hyshum/19-13-GreenHouse/Hardware/README_HARDWARE.md

# Hardware ReadMe
The hardware portion of this project can be broken down into three core sections:
* Enternal structure
* Internal structure
* Sensor circuitry

## External Structure
The external structure of the greenhouse is has two main components: the wooden base and the PVC pipe frame. The wooden base was created by screwing together treated cedar lumber boards to create the sides of the box. These were then screwed into one piece of plywood which created the floor of the box. To make transportation of the greenhouse easier, wheels were attached to the bottom to allow the greenhouse to be rolled. The next component, the PVC pipe frame, was constructed by cutting pieces of pipe to their specified lengths and multiple differnt joints were used to connect these pieces together. A primer was then used to prepare the pipe to be cemented together. To secure the frame to the base, plastic blocks were machined to create holes large enough to securely hold the frame in. These blocks were then attached to the base using a multi-surface epoxy. After the frame was securely in place in the base, the polyethylene plastic was attached to the frame using PVC pipe clamps. Two layers of plastic were attached to the frame, an inner and an outer layer, to create an air gap which acts as an insullation layer. The door of the greenhouse was created using two-adhesive zippers placed into a backwards L shape. When both zippers are unzipped, it creates a flap in the polyethylene that can be pulled out creating a door to the interior of the greenhouse. All of the sketches and photographs pertaining to the external structure of the greenhouse are placed in the [External-Structure](External-Structure) folder.

## Internal Structure
The internal structure of EcoHome is composed of the following: a sub-floor, four plywood supports for the sub-floor, and a heating pad. The sub-floor serves as the surface on which the plants will rest. Two pieces of plywood joined together by a continuous hinge comprise this component. To give the user easy access to the area beneath the floor, handles are found on the two sides of the plywood panels parallel to the continuous hinge. Currently, the power strip &ndash; EcoHome's main electricity provider &ndash; is located along the right cedar wall of the base. For quick maintenance, the user can raise one panel 90 degrees. However, if more exposure is needed of the area below the sub-floor, the user can lift both panels (which can collapse up to 30 degrees) and remove the component entirely.

The heating pad consists of a plywood base and five equally spaced, pine furring strips with an incandescent rope light looped between them. Four evenly spaced sets of corner brackets are fastened to the outermost furring strips. Each set of brackets are separated by a 9/16in. space, allowing the plywood supports to fit snugly between them. Since the brackets are not attached to the supports, they can be removed with a pull if maintenance needs to be done to the rope light. All of the sketches and photographs pertaining to the internal structure of the greenhouse are placed in the [Internal-Structure](Internal-Structure) folder.

_Important safety instructions for the incandescent rope light can be found in the [Internal-Structure](Internal-Structure) folder_

## Sensor Circuitry
Datasheets for the electronics used are listed below:
* [DHT11 Temperature and Humidity Module](https://www.mouser.com/ds/2/758/DHT11-Technical-Data-Sheet-Translated-Version-1143054.pdf)
* [QLOUNI Soil Moisture Sensor](https://randomnerdtutorials.com/guide-for-soil-moisture-sensor-yl-69-or-hl-69-with-the-arduino/)
* [NSL19M51 Photoresistor](https://lunainc.com/wp-content/uploads/2016/06/NSL-19M51.pdf)
* [Wemo Mini Smart Plug](https://www.belkin.com/us/support-article?articleNum=226110)
* [Ardunio Genuino Uno](https://www.farnell.com/datasheets/1682209.pdf)
* [NodeMCU (ESP8266)](https://einstronic.com/wp-content/uploads/2017/06/NodeMCU-ESP8266-ESP-12E-Catalogue.pdf)
* [Incandescent Rope Light](https://persik.com/collections/rope-lights/products/persik-18-feet-red-rope-light-for-indoor-and-outdoor-use-pack-of-2-total-36-feet-length)

All of the diagrams pertaining to the electronics involved in the greenhouse are placed in the [Sensor-Circuitry](Sensor-Circuitry) folder.

### Bill of Materials:
_For items purchased online, a link is provided to connect you to corresponding webpage._

Item | Cost per Item | Quantity | Number Included in Package | Total Cost |
---- | ------------- | -------- | -------------------------- | ---------- |
PVC Pipe | $5.13 | 4 | 1 | $20.52
[PVC Joint: 90 Degree Elbow](https://www.amazon.com/gp/product/B01LVUU8EX/ref=ppx_yo_dt_b_asin_title_o04_s00?ie=UTF8&th=1) | $2.13 | 2 | 1 | $4.26
[PVC Joint: 45 Degree Elbow](https://www.homedepot.com/p/Charlotte-Pipe-1-1-2-in-PVC-Sch-40-45-Degree-S-x-S-Elbow-PVC023091400HD/203812169) | $1.26 | 4 | 1 | $5.04
PVC Primer and Cement | $9.17 | 1 | 1 | $9.17
[PVC Joint: 4-Way Tree](https://smile.amazon.com/gp/product/B072C2FBJJ/ref=ppx_od_dt_b_asin_title_o00_s00?ie=UTF8&psc=1) | $15.25 | 1 | 4 | $15.25
[Snap Clamps](https://smile.amazon.com/gp/product/B00C7DPS2S/ref=ppx_od_dt_b_asin_title_o00_s01?ie=UTF8&psc=1) | $10.45 | 4 | 10 | $41.80
Cedar Lumber: 2in. x 10in. x 12ft. | $18.77 | 1 | 1 | $18.77
BC Plywood: 4ft. x 4ft. | $20.88 | 1 | 1 | $20.88
[Polyethlene Film: 12ft. x 25ft.](https://smile.amazon.com/Greenhouse-Plastic-Polyethylene-Covering-Solution/dp/B00BM8HHKK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) | $57.94 | 1 | 1 | $57.94
Adhesive Zipper | $17.99 | 1 | 1 | $17.99
Incandescent Rope Light | $33.98 | 1 | 2 | $33.98
Continuous Hinge (30in.) | $7.47 | 1 | 1 | $7.47
Corner Brace (2in.) | $2.56 | 3 | 4 | $7.68
Corner Bracket | $7.48 | 1 | 20 | $7.48
Wood Screws: #4 x 1in. | $1.18 | 4 | 10 | $4.72
Wood Screws: #8 x 1/2in. | $9.19 | 1 | 1 | $9.19
BC Plywood: 1/2in. x 2ft. x 4ft. | $13.92 | 2 | 1 | $27.84
Pine Furring Strip: 1in. x 2in. x 8ft. | $1.42 | 1 | 1 | $1.42
Door Handle | $2.97 | 2 | 1 | $5.94
Ardunio Genuino Uno | $22.00 | 1 | 1 | $22.00
[DHT11 Temperature and Humidity Module](https://www.amazon.com/HiLetgo-Temperature-Humidity-Arduino-Raspberry/dp/B01DKC2GQ0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) | $9.99 | 2 | 5 | $9.99
NodeMCU (ESP8266) | $8.39 | 1 | 1 | $8.39
[QLOUNI Soil Moisture Sensor](https://www.amazon.com/QLOUNI-Hygrometer-Humidity-Detection-Automatic/dp/B077F4WXX6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) | $7.99 | 1 | 5 | $7.99
NSL19M51 Photoresistor | $1.13 | 1 | 1 | $1.13
Wemo Mini Smart Plug | $16.89 | 1 | 1 | $16.89
Solid Core Wire (1ft.) | $0.29 | 1 | 25 | $7.99

### Vendor Information:
_All hyperlinks will direct you to that vendor's information page if you're interested in learning more about the company._

Vendor Info | Item(s)
----------- | -----------
[The Home Depot](https://corporate.homedepot.com/about) | <ul><li>PVC Pipe:</li><li>[Genova](https://www.genovaproducts.com/index.html) Schedule 40 Pressure Pipe, 1-1/2 in. x 10 ft., Plain End</li><ul><li>PVC Joints: </li><ul><li>90 Degree Elbow</li><li>45 Degree Elbow</li></ul></ul><li>BC Plywood</li><li>Continuous Hinge</li><li>Corner Brace</li><li>Corner Bracket</li><li>Door Handle</li><li>Everbilt Wood Screws</li><li>Cedar Lumbar</li><li>Pine Furring Strips</li></ul>
[Amazon](https://www.aboutamazon.com/?utm_source=gateway&utm_medium=footer) | <ul><li>Arduino Genuino Uno</li><li>DHT11 Temperature and HUmidity Module</li><li>NodeMCU (ESP8266)</li><li>[Persik](https://persik.com/pages/about-us) Incadescent Rope Light</li><li>Wemo Mini Smart Plug</li><li>Adhesive Zipper</li><li>Polyethlene Film</li><li>Snap Clamps</li><li>PVC Joint: 4-Way Tree</li></ul>
