hyshum/19-13-GreenHouse/Hardware/Sensor-Circuitry/SENSOR_CIRCUITRY_README.md

# Sensor Circuitry ReadMe
This repository contains all diagrams of the main circuit drafted using computer software or by hand.
