hyshum/19-13-GreenHouse/Hardware/Sensor-Circuitry/Circuit_Schematic.pdf

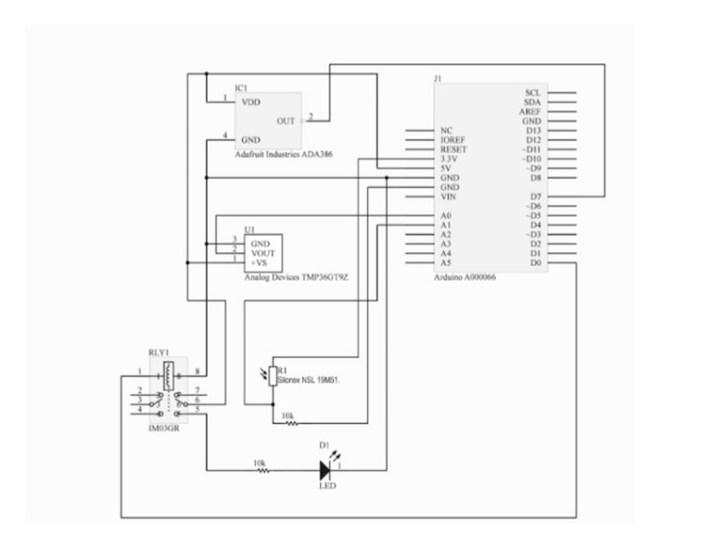
[picture p2: page 1]
