hyshum/19-13-GreenHouse/Hardware/Internal-Structure/Sketches/Heating_Pad_Sketch.pdf

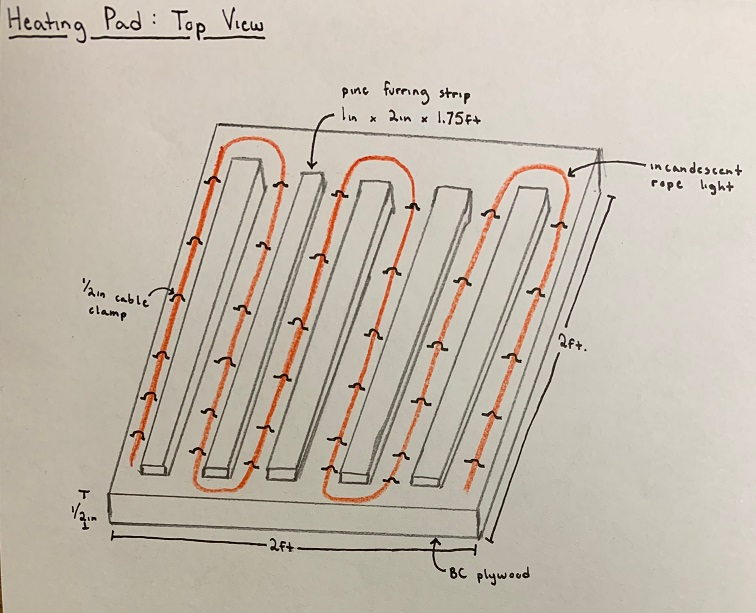
[picture p3: page 1]
