hyshum/19-13-GreenHouse/Hardware/Internal-Structure/Sketches/Subfloor_Sketches_(Aerial_and_Side).pdf

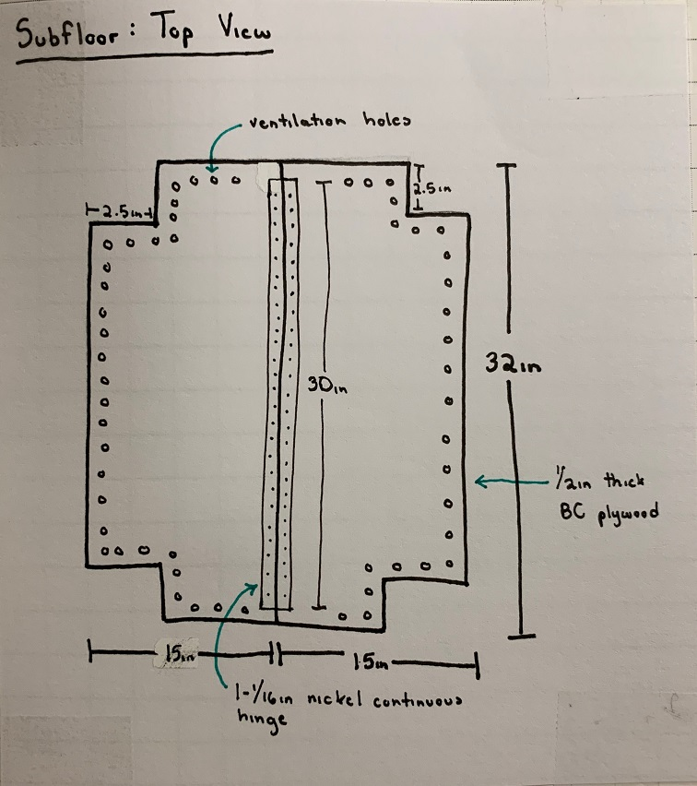
[picture p4: page 1]
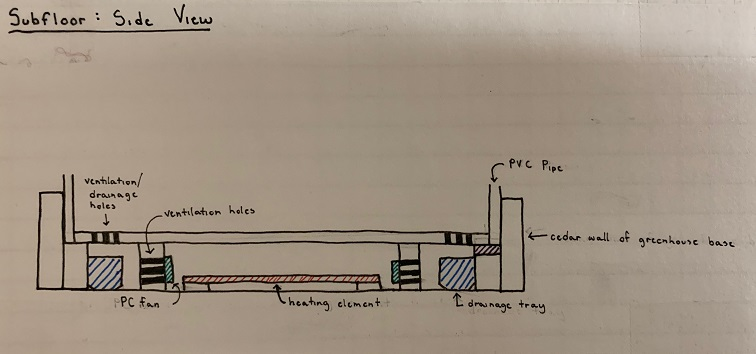
[picture p5: page 2]
