hyshum/19-13-GreenHouse/Hardware/Internal-Structure/Photos/Aerial_View_of_Heating_Pad_(General_and_Energized).pdf

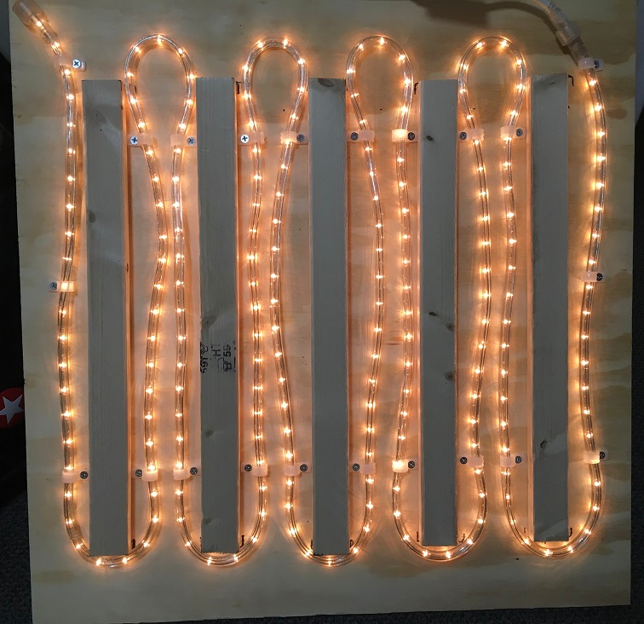
[picture p6: page 1]
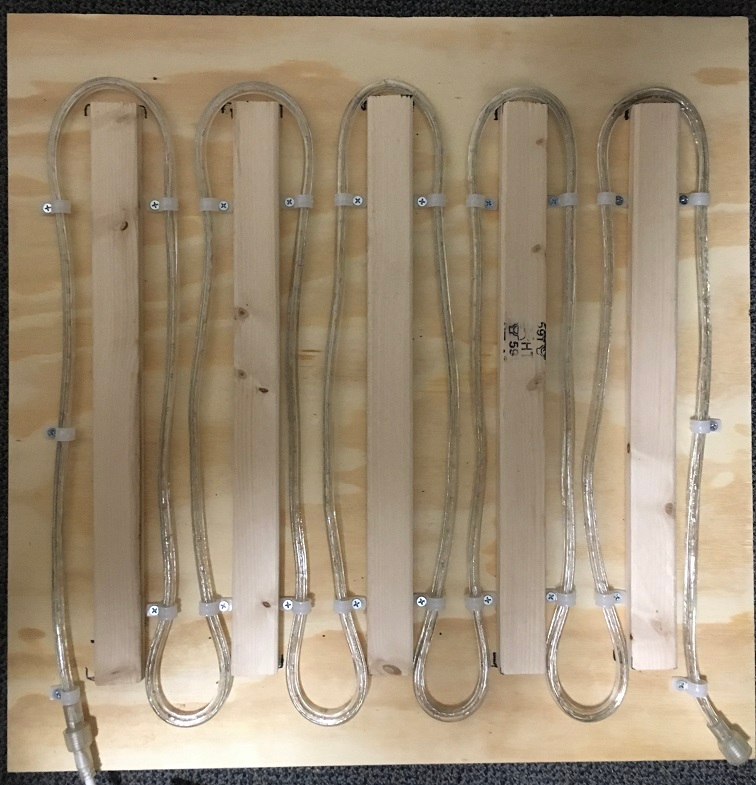
[picture p7: page 2]
