hyshum/19-13-GreenHouse/Hardware/Internal-Structure/Photos/Aerial_View_of_Subfloor.pdf

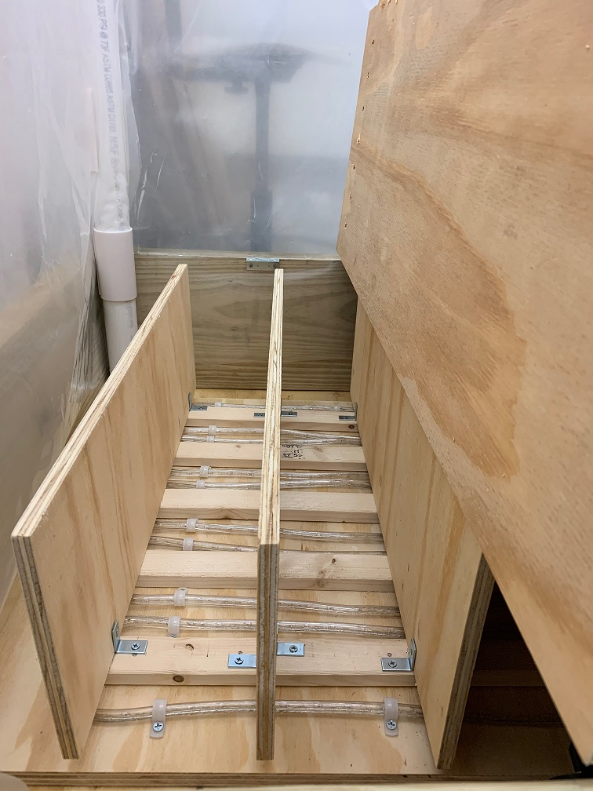
[picture p8: page 1]
