hyshum/19-13-GreenHouse/Hardware/External-Structure/Sketches/Design for door.pdf

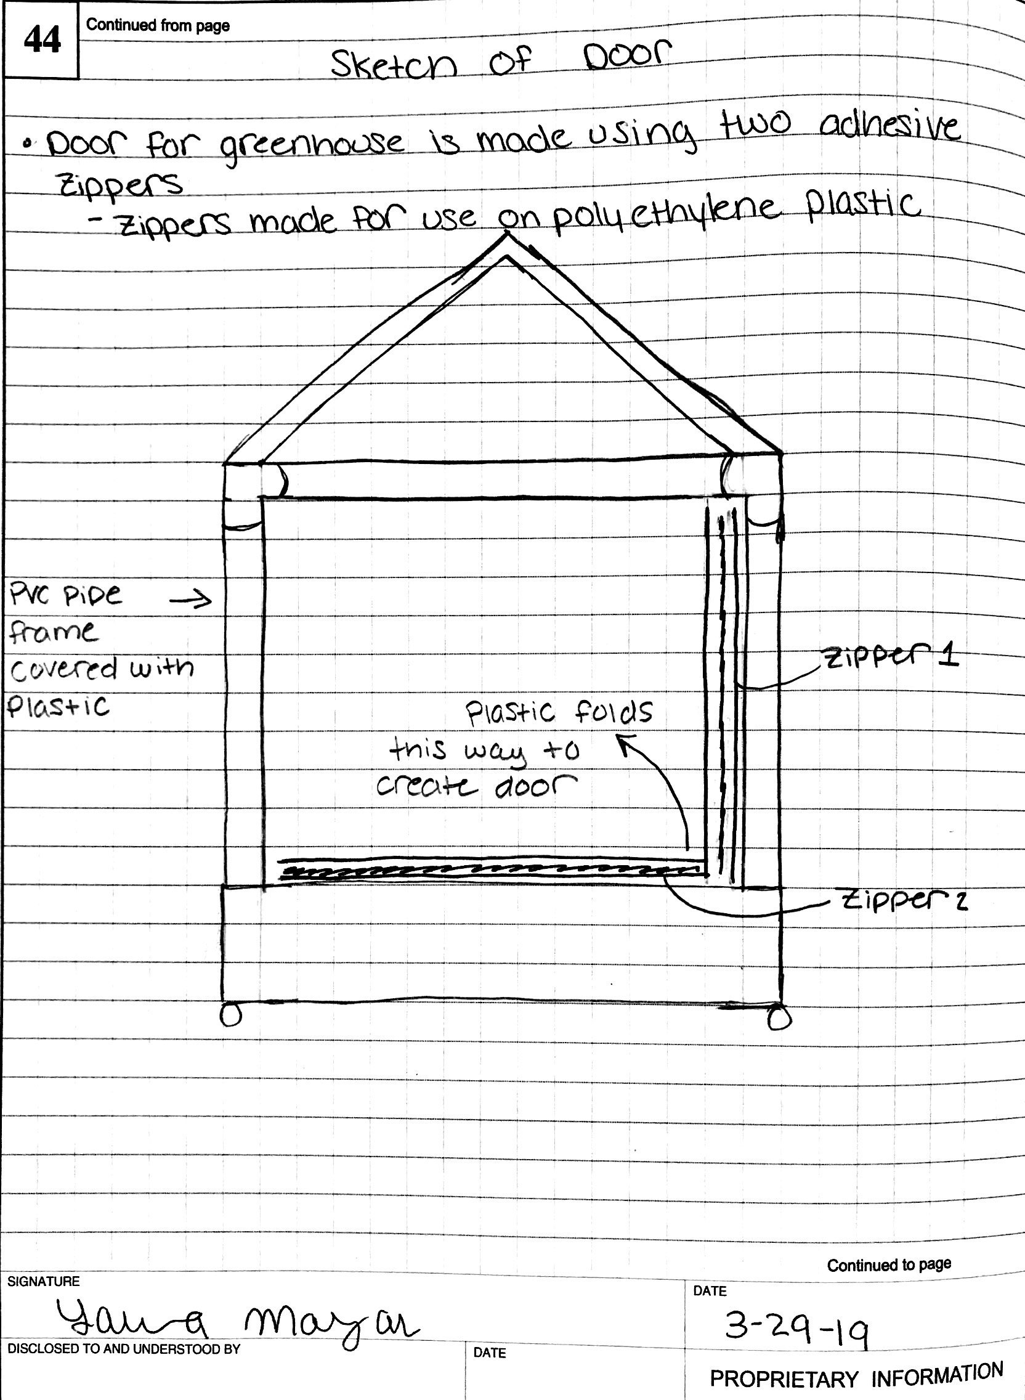
[picture p9: page 1]

Scanned with CamScanner
