hyshum/19-13-GreenHouse/Hardware/External-Structure/Sketches/Final Design - 3-d view.pdf

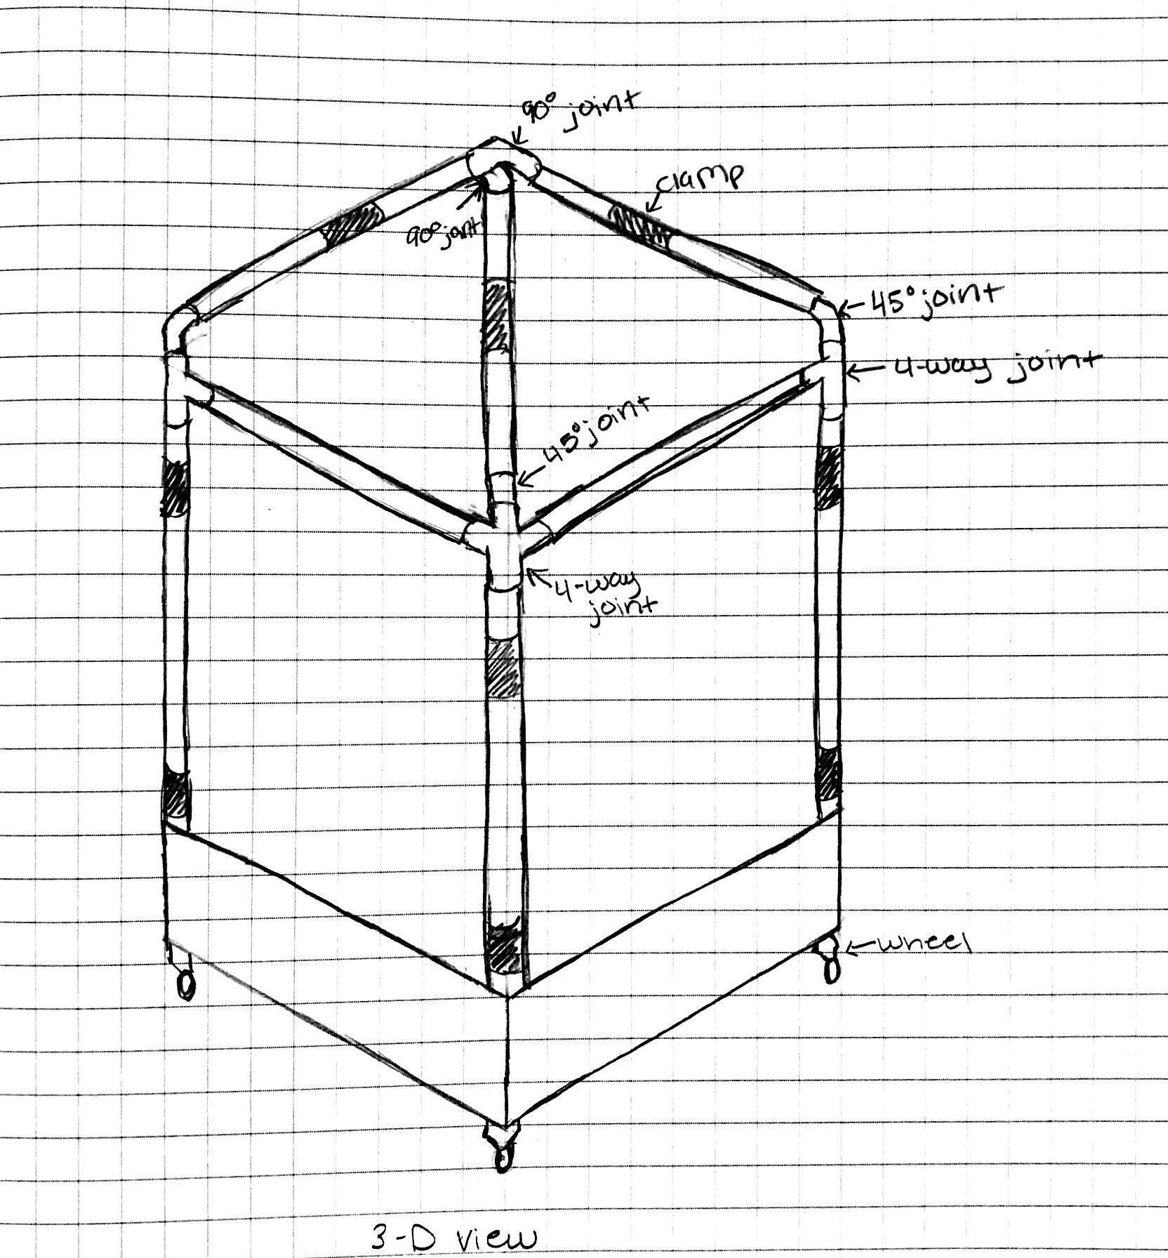
[picture p10: page 1]

Scanned with CamScanner
