hyshum/19-13-GreenHouse/Hardware/External-Structure/Sketches/Final Design - Front View.pdf

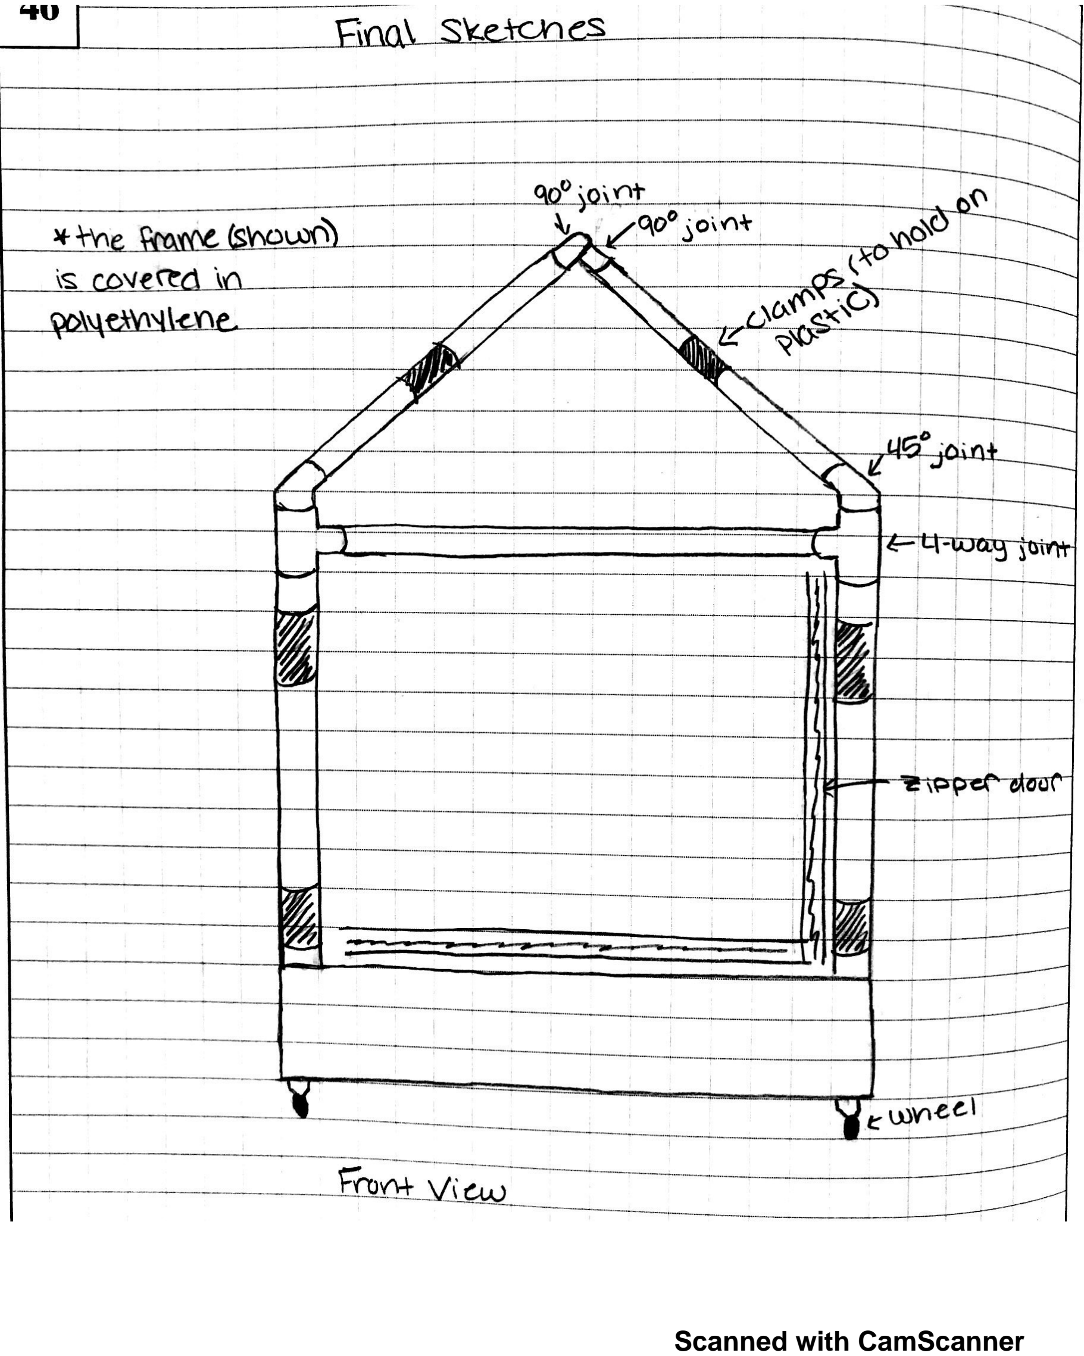
[picture p11: page 1]

Scanned with CamScanner
