hyshum/19-13-GreenHouse/Hardware/External-Structure/Sketches/Initial design for blocks.pdf

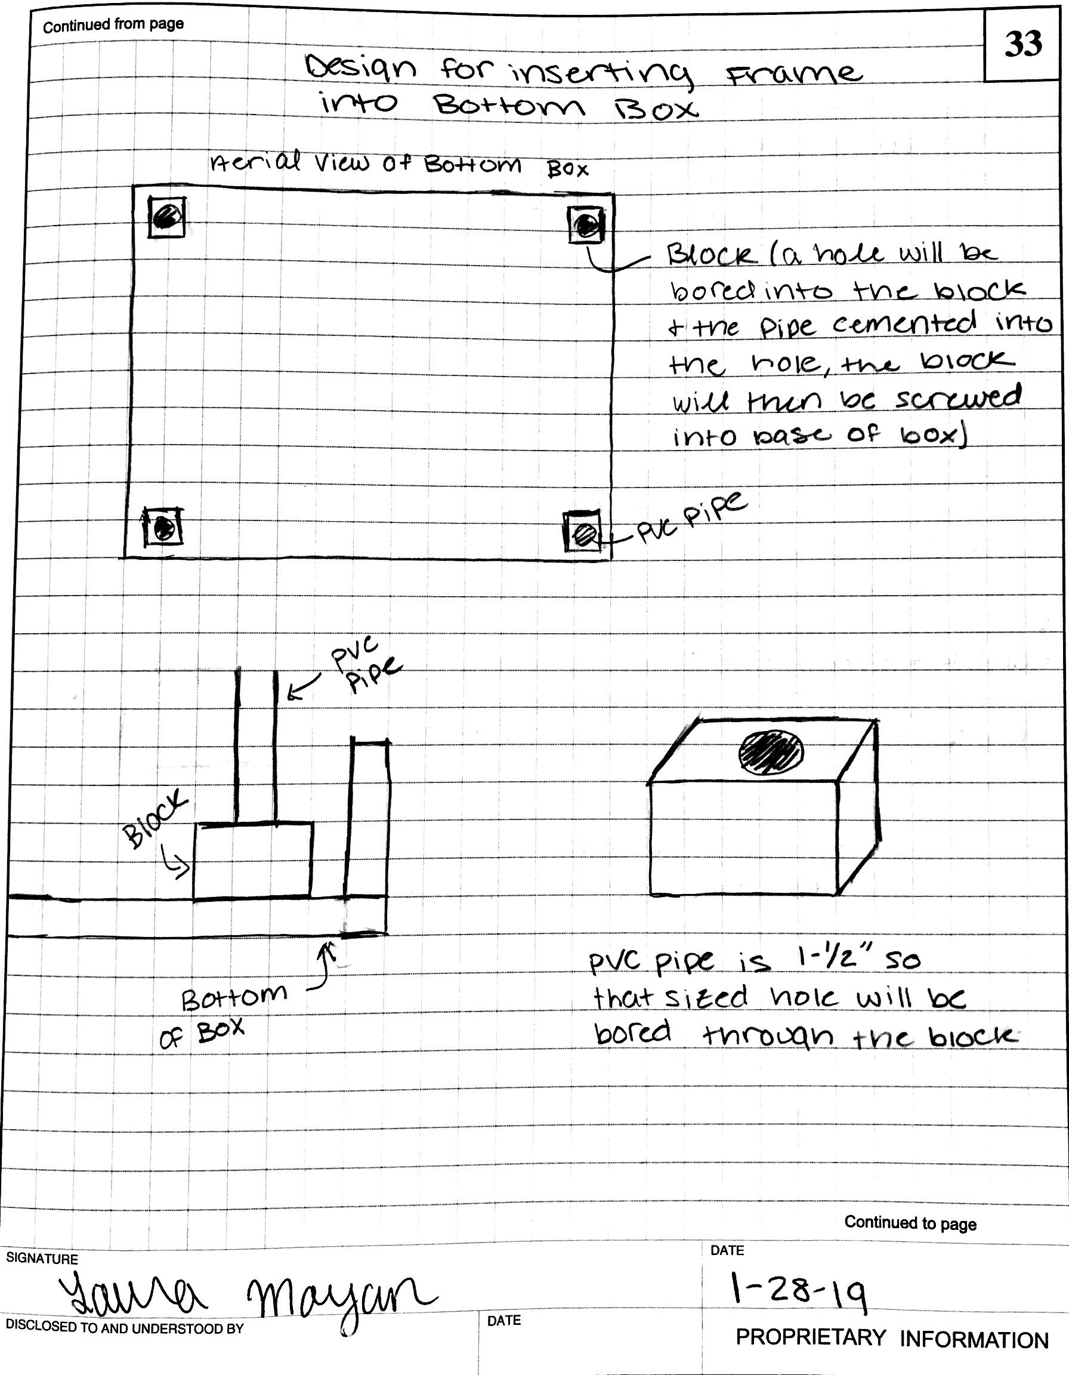
[picture p12: page 1]

Scanned with CamScanner
