hyshum/19-13-GreenHouse/Hardware/External-Structure/Sketches/Updated design for blocks.pdf

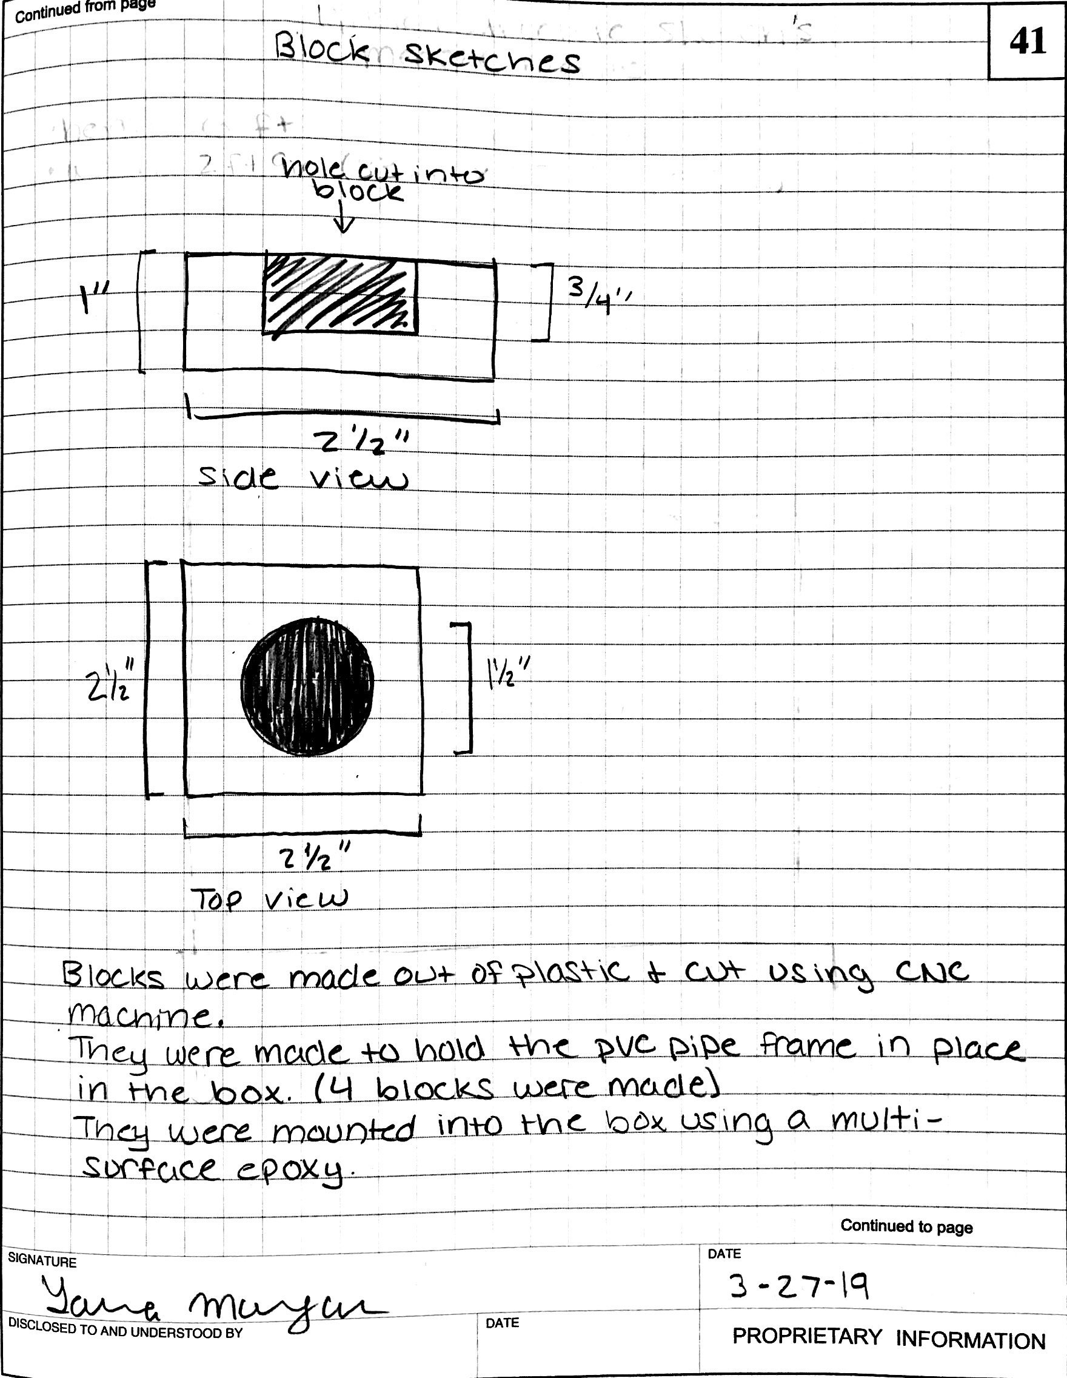
[picture p13: page 1]

Scanned with CamScanner
