hyshum/19-13-GreenHouse/Hardware/External-Structure/Photos/built structure.jpg

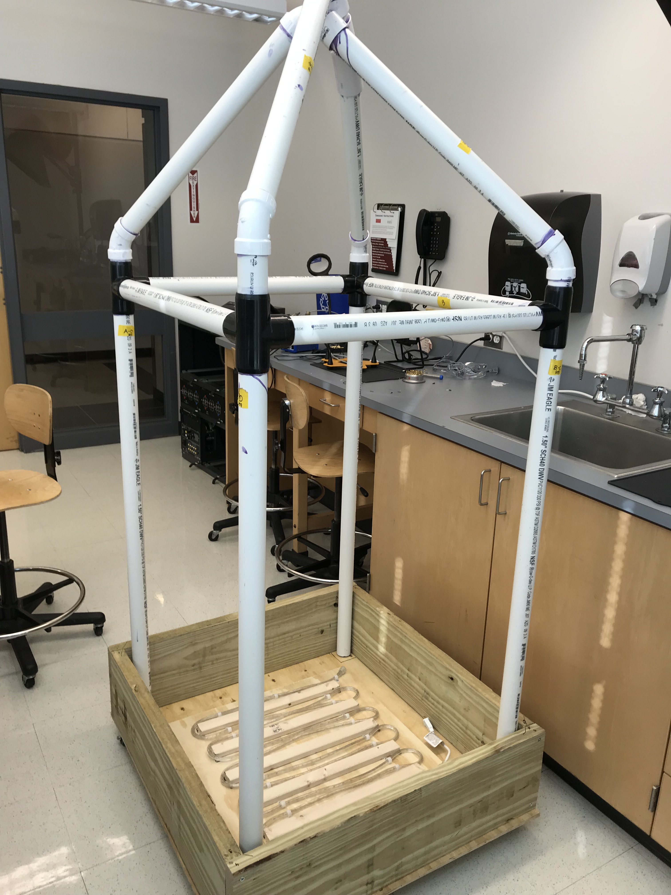
Hardware/External-Structure/Photos/built structure.jpg
