hyshum/19-13-GreenHouse/Hardware/External-Structure/Photos/Final Structure.jpg

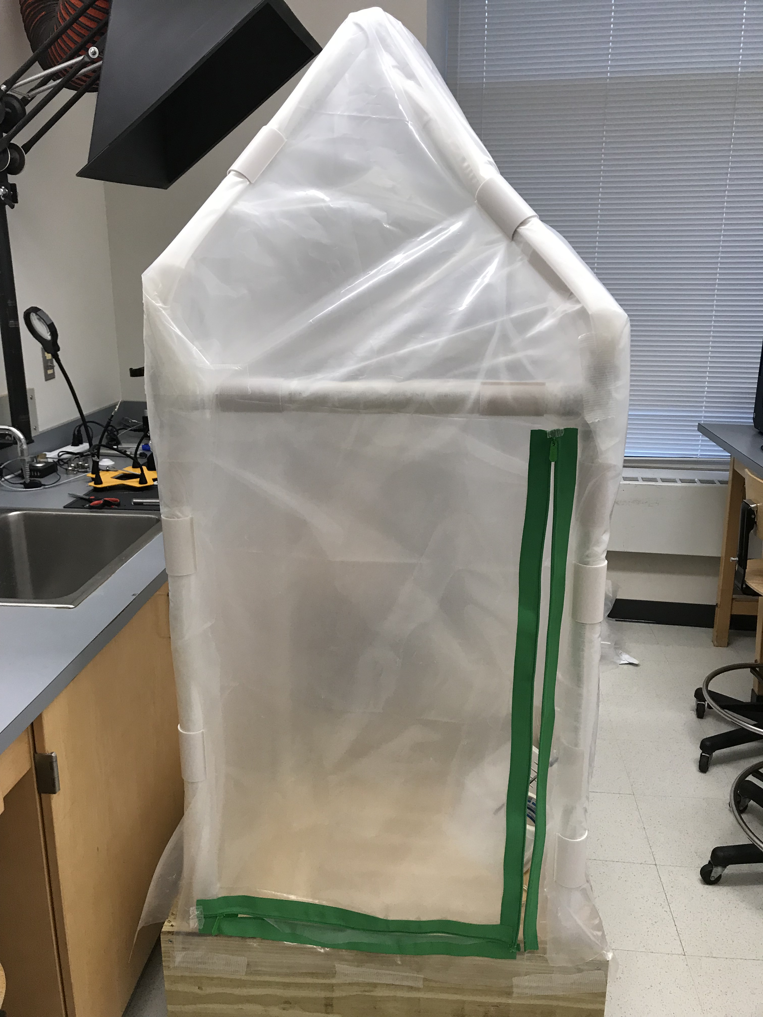
Hardware/External-Structure/Photos/Final Structure.jpg
