hyshum/19-13-GreenHouse/Hardware/External-Structure/Sketches/3-d view of frame.jpg

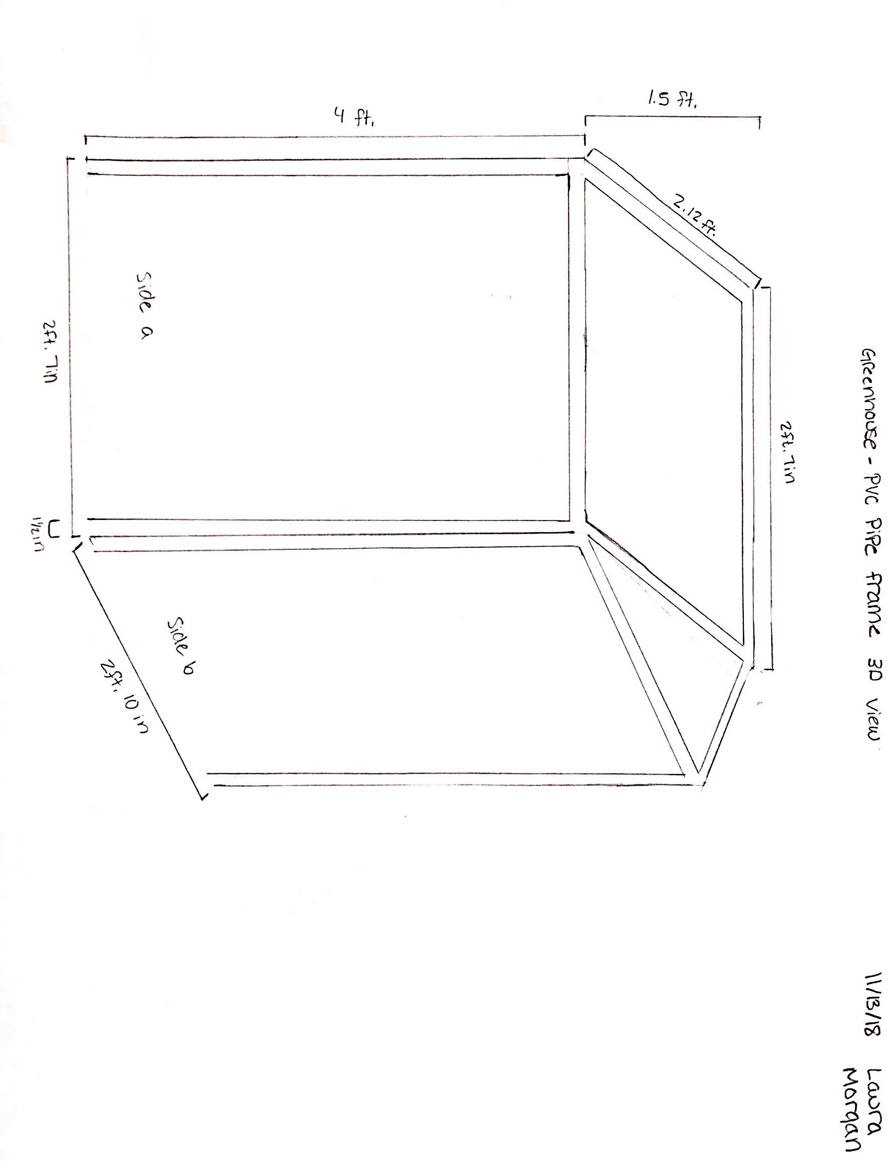
Hardware/External-Structure/Sketches/3-d view of frame.jpg
