hyshum/19-13-GreenHouse/Hardware/External-Structure/Sketches/Box - 3-d view.jpg

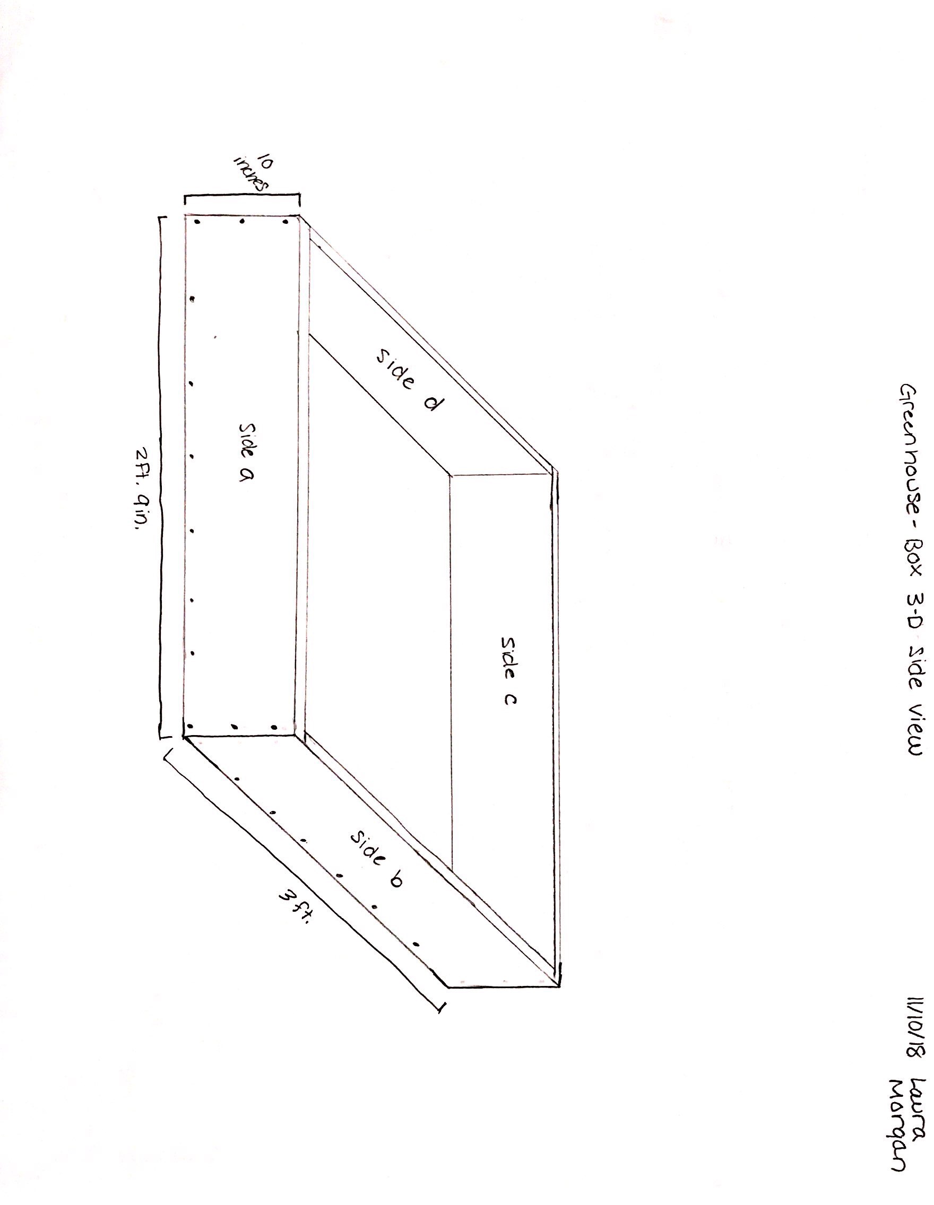
Hardware/External-Structure/Sketches/Box - 3-d view.jpg
