hyshum/19-13-GreenHouse/Hardware/External-Structure/Sketches/Box - Bottom View.jpg

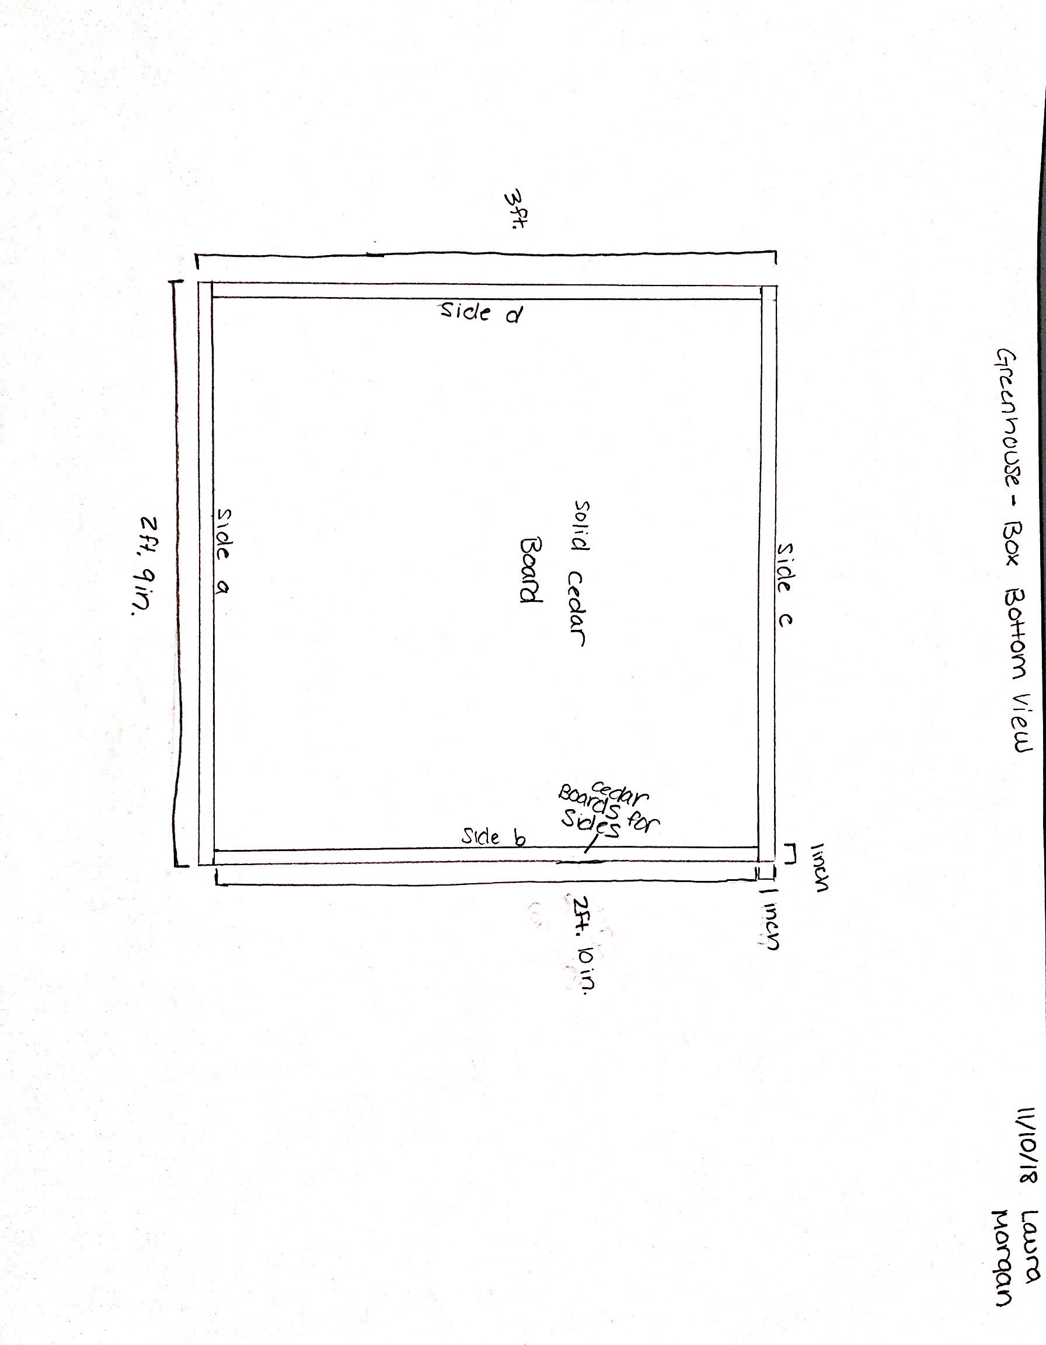
Hardware/External-Structure/Sketches/Box - Bottom View.jpg
