hyshum/19-13-GreenHouse/Hardware/External-Structure/Sketches/Side View.jpg

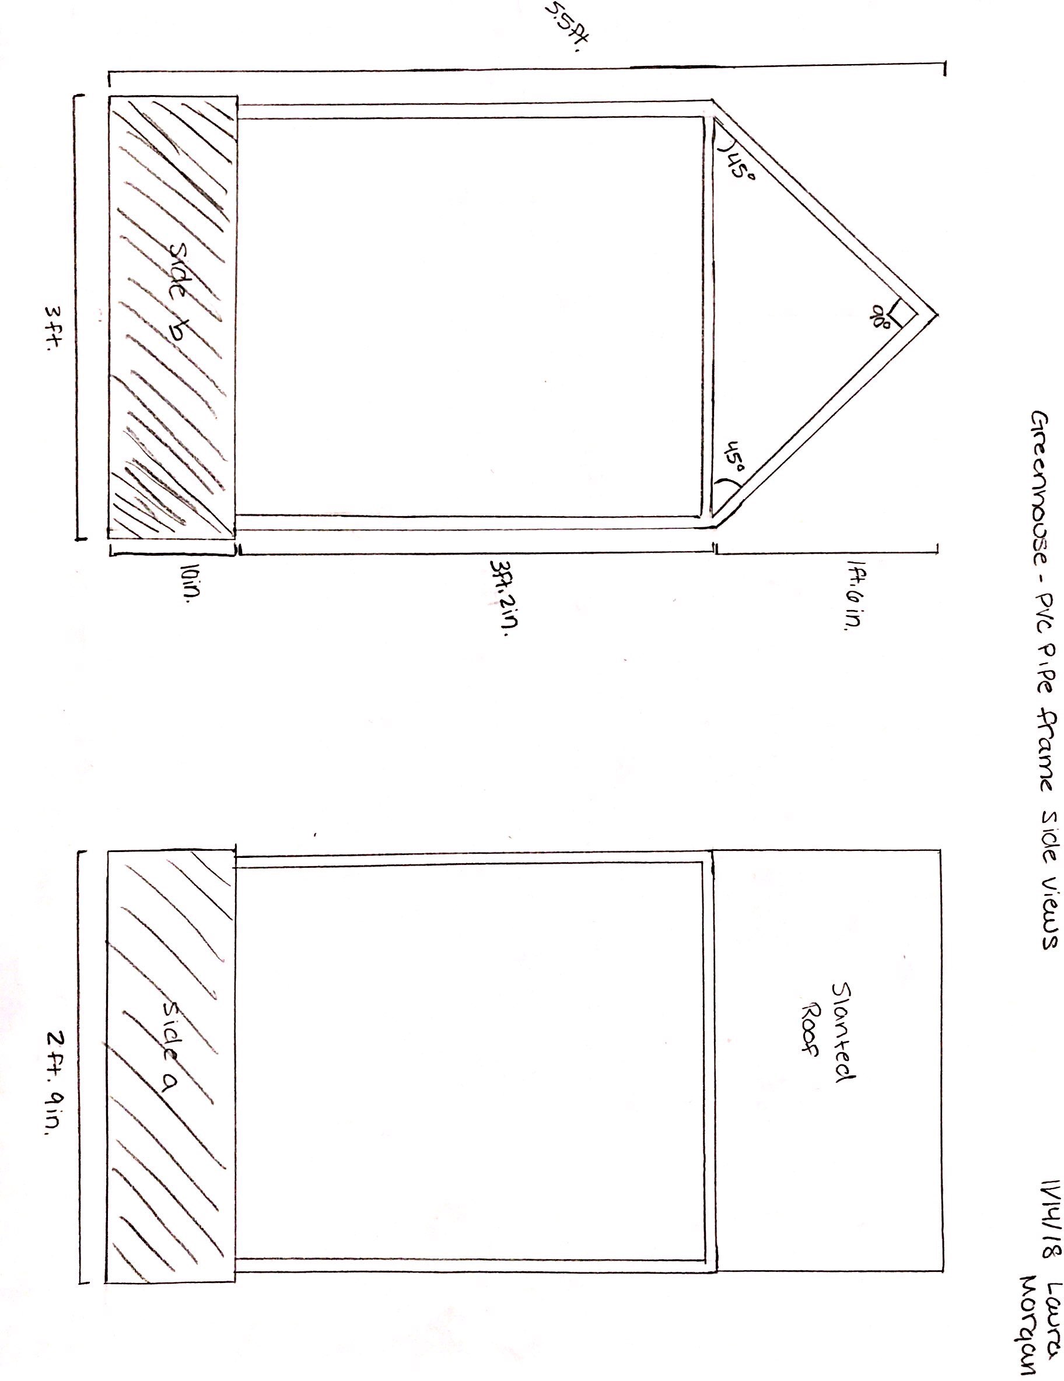
Hardware/External-Structure/Sketches/Side View.jpg
