hyshum/19-13-GreenHouse/Hardware/External-Structure/Sketches/structure concept.png

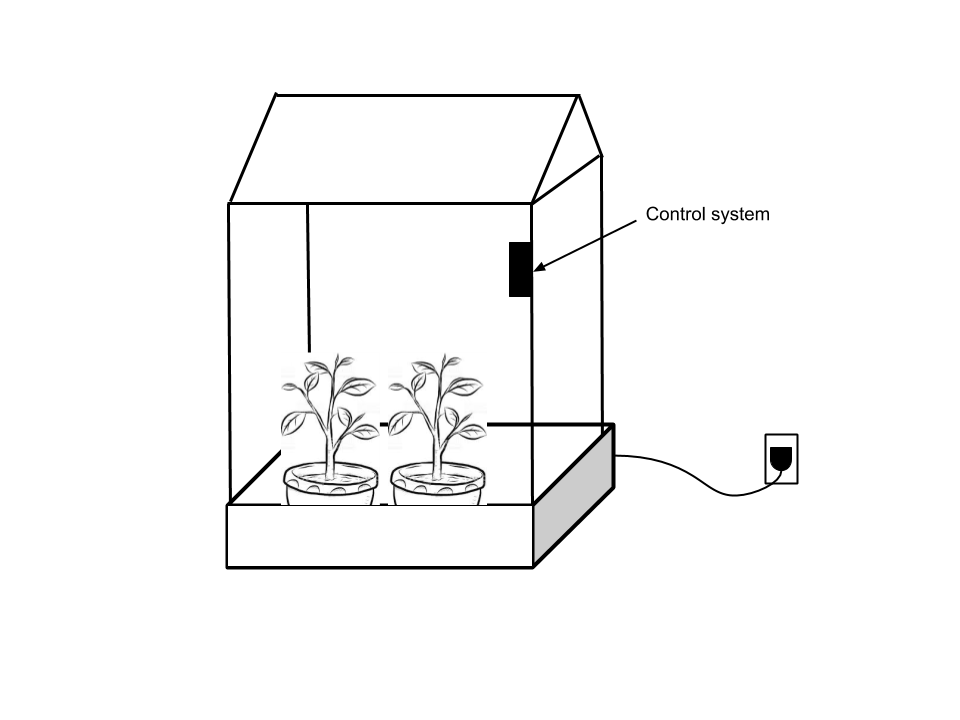
Hardware/External-Structure/Sketches/structure concept.png
