hyshum/19-13-GreenHouse/Hardware/Internal-Structure/Photos/Aerial_View_of_Subfloor.JPG

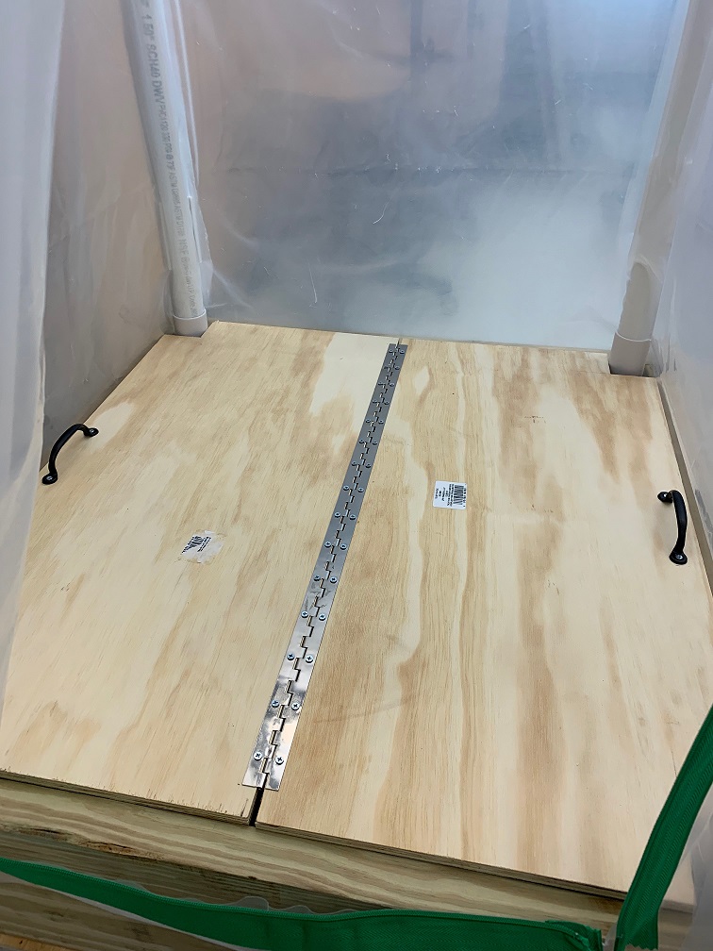
Hardware/Internal-Structure/Photos/Aerial_View_of_Subfloor.JPG
