hyshum/19-13-GreenHouse/Hardware/Internal-Structure/Incandescent_Rope_Light_Safety_Instructions.pdf

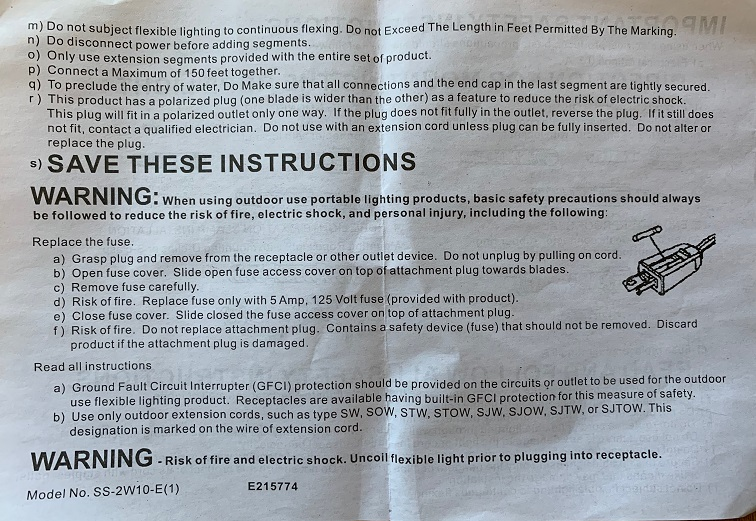
[picture p34: page 1]
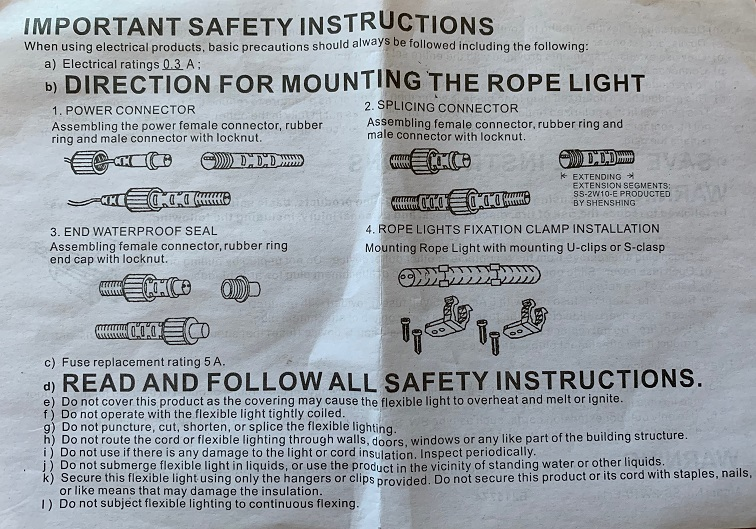
[picture p35: page 2]
