hyshum/19-13-GreenHouse/Software/Arduino_and_NodeMCU_Embedded_System/test_wifi/node_mcu/node_mcu.ino

// Libraries
#include <ESP8266WiFi.h>
#include <ArduinoJson.h>
#include <WifiClientSecure.h>
#include <MQTT.h>
#include <time.h>
#include "secrets.h"
// WiFi network

uint8_t DST = 0;
const int MQTT_PORT = 8883;
const char MQTT_SUB_TOPIC[] = "$aws/things/Greenhouse_final/shadow/update";
const char MQTT_PUB_TOPIC[] = "$aws/things/Greenhouse_final/shadow/update";
int threshold_temperature = 80;
//int soil_moisture = 10;


#define DHT11_PIN D1 //Nodemcu: D1, Arduino: 4
#define LIGHT_PIN D3  //Nodemcu: D2, Arduino: 0
#define OUTSIDE_TEMP_PIN A0  //Nodemcu: D5, Arduino: 1
#define WRITE_PIN D0
#define READ_PIN D5
#define LED_PIN D1
#define WIFI_ON D2
//#define Soil_moisture_PIN A0  //Nodemcu: D7, Arduino: 1
int in1 = D6;  //Nodemcu: D6, Arduino: 7

double tempOutF;
double temp;
double humidity;
int soilMoisture;
int soilMoisture2;
int soilMoisture3;
int on;
int photoCellReading;
bool changeTemp = false;
int soilCorrected;
int soilCorrected2;
int soilCorrected3;
unsigned long StartTime;
unsigned long FinishTime;
unsigned long RunningTime;
unsigned long TotalRunningTime = 0;
int heaterindex = 0;
int Warning_temperture_low = 0;
int Hourminsec = 0;
int Yearmonthdate = 0;
unsigned long startTimeout;
unsigned long endTimeout;
unsigned long timeout = 30000;

int sensorValue = 0;  
int percent = 0;
String percentString ="0";
int stringLength = 0;

WiFiClientSecure net;

BearSSL::X509List cert( cacert );
BearSSL::X509List client_crt( client_cert );
BearSSL::PrivateKey key( privkey );

MQTTClient client;
unsigned long lastMillis = 0;
time_t now;
time_t nowish = 1510592825;

void NTPConnect(void)
{
  
    configTime( TIME_ZONE * 3600, DST * 3600, "pool.ntp.org", "time.nist.gov" );
    now = time( nullptr );
    while( now < nowish )
    {
      delay( 500 );
      now = time( nullptr );
    }
    struct tm timeinfo;
    gmtime_r( &now, &timeinfo );
}

void messageReceived(String &topic, String &payload)
{
  //Serial.println("Recieved [" + topic + "]: " + payload);
}



void lwMQTTErr(lwmqtt_err_t reason)
{
  
  if (reason == lwmqtt_err_t::LWMQTT_SUCCESS)
    Serial.print("Success");
  else if (reason == lwmqtt_err_t::LWMQTT_BUFFER_TOO_SHORT)
    Serial.print("Buffer too short");
  else if (reason == lwmqtt_err_t::LWMQTT_VARNUM_OVERFLOW)
    Serial.print("Varnum overflow");
  else if (reason == lwmqtt_err_t::LWMQTT_NETWORK_FAILED_CONNECT)
    Serial.print("Network failed connect");
  else if (reason == lwmqtt_err_t::LWMQTT_NETWORK_TIMEOUT)
    Serial.print("Network timeout");
  else if (reason == lwmqtt_err_t::LWMQTT_NETWORK_FAILED_READ)
    Serial.print("Network failed read");
  else if (reason == lwmqtt_err_t::LWMQTT_NETWORK_FAILED_WRITE)
    Serial.print("Network failed write");
  else if (reason == lwmqtt_err_t::LWMQTT_REMAINING_LENGTH_OVERFLOW)
    Serial.print("Remaining length overflow");
  else if (reason == lwmqtt_err_t::LWMQTT_REMAINING_LENGTH_MISMATCH)
    Serial.print("Remaining length mismatch");
  else if (reason == lwmqtt_err_t::LWMQTT_MISSING_OR_WRONG_PACKET)
    Serial.print("Missing or wrong packet");
  else if (reason == lwmqtt_err_t::LWMQTT_CONNECTION_DENIED)
    Serial.print("Connection denied");
  else if (reason == lwmqtt_err_t::LWMQTT_FAILED_SUBSCRIPTION)
    Serial.print("Failed subscription");
  else if (reason == lwmqtt_err_t::LWMQTT_SUBACK_ARRAY_OVERFLOW)
    Serial.print("Suback array overflow");
  else if (reason == lwmqtt_err_t::LWMQTT_PONG_TIMEOUT)
    Serial.print("Pong timeout");
}

void lwMQTTErrConnection(lwmqtt_return_code_t reason)
{
  
  if (reason == lwmqtt_return_code_t::LWMQTT_CONNECTION_ACCEPTED)
    Serial.print("Connection Accepted");
  else if (reason == lwmqtt_return_code_t::LWMQTT_UNACCEPTABLE_PROTOCOL)
    Serial.print("Unacceptable Protocol");
  else if (reason == lwmqtt_return_code_t::LWMQTT_IDENTIFIER_REJECTED)
    Serial.print("Identifier Rejected");
  else if (reason == lwmqtt_return_code_t::LWMQTT_SERVER_UNAVAILABLE)
    Serial.print("Server Unavailable");
  else if (reason == lwmqtt_return_code_t::LWMQTT_BAD_USERNAME_OR_PASSWORD)
    Serial.print("Bad UserName/Password");
  else if (reason == lwmqtt_return_code_t::LWMQTT_NOT_AUTHORIZED)
    Serial.print("Not Authorized");
  else if (reason == lwmqtt_return_code_t::LWMQTT_UNKNOWN_RETURN_CODE)
    Serial.print("Unknown Return Code");
    
}

//Connect to MQTT
void connectToMqtt(bool nonBlocking = true)
{
  Serial.print("MQTT connecting ");
  while (!client.connected())
  {
    Serial.println( "not connected" );
    if (client.connect(THINGNAME))
    {
      Serial.println( "connected" );

      if (!client.subscribe(MQTT_SUB_TOPIC))
        lwMQTTErr(client.lastError());
    }
    else
    {
      Serial.print("failed, reason -> ");
      lwMQTTErrConnection(client.returnCode());
      if (!nonBlocking)
      {
        Serial.println(" < try again in 5 seconds");
        delay(5000);
      }
      else
      {
        Serial.println(" <");
      }
    }
    if (nonBlocking)
      break;
  }
}

//connect to wifi network
void connectToWiFi(String init_str)
{
  while (WiFi.status() != WL_CONNECTED)
  {
    delay(1000);
  }
}

void checkWiFiThenMQTT(void)
{
  connectToWiFi("Checking WiFi");
  connectToMqtt();
}

unsigned long previousMillis = 0;
const long interval = 5000;

void checkWiFiThenMQTTNonBlocking(void)
{
  connectToWiFi(emptyString);
  if (millis() - previousMillis >= interval && !client.connected()) {
    previousMillis = millis();
    connectToMqtt(true);
  }
}

void checkWiFiThenReboot(void)
{
  connectToWiFi("Checking WiFi");
  ESP.restart();
}
DynamicJsonDocument jsonBuffer(1024);

void sendData(void)
{
  //assign all elements to json document and then send to MQTT
  
  JsonObject root = jsonBuffer.to<JsonObject>();
  JsonObject state = root.createNestedObject("state");
  JsonObject state_reported = state.createNestedObject("reported");
    state_reported["ti"] = temp;   
  state_reported["to"] = tempOutF;  
  state_reported["h"] = humidity;   
  state_reported["l"] = photoCellReading;    
  state_reported["a"] = soilCorrected;      
  state_reported["b"] = soilCorrected2;
  state_reported["c"] = soilCorrected3;

  char shadow[measureJson(root) + 1];
  serializeJson(root, shadow, sizeof(shadow));
  if (!client.publish(MQTT_PUB_TOPIC, shadow, false, 0))
    lwMQTTErr(client.lastError());
  jsonBuffer.clear();
}


String incomingString;


void setup() {

  //write pin indicates nodeMCU -> Arduino comm
  pinMode(WRITE_PIN, OUTPUT);
  digitalWrite(WRITE_PIN, LOW);

  //read pin indicates Arduino -> nodeMCU comm
  pinMode(READ_PIN, INPUT);

  //LED pin just used to indicate accepting data
  pinMode( LED_PIN, OUTPUT );
  digitalWrite( LED_PIN, LOW );
  
  // Start serial
  Serial.begin(115200);
  Serial.println( "begin" );
  
  // Connecting to a WiFi network
  WiFi.hostname( THINGNAME );
  WiFi.mode( WIFI_STA );
  WiFi.begin( ssid, password );
  connectToWiFi(String( "connecting..." ) );
  NTPConnect();
  Serial.println( "wifi" );
  net.setTrustAnchors( &cert );
  net.setClientRSACert( &client_crt, &key );
  client.begin( MQTT_HOST, MQTT_PORT, net );
  client.onMessage( messageReceived );

  connectToMqtt();
  delay( 500 );
}

String sensorArray[7];

//parse string to extract measurements and assign
void parseString( String input )
{
 int len =  input.length();
 String current = "";
 int pos = 0;
 //iterate through measurements
 for( int i = 0; i < len; i++ )
 {

  //useful if number or decimal point
  if( isDigit( input.charAt(i) ) || input.charAt(i) == '.' )
  {
    current += input.charAt( i );
  }
  //semicolon used to separate measurements
  else if( input.charAt(i) == ';' )
  {
    if( pos < 8 )
    {
      sensorArray[pos] = current;
      current = "";
      pos = pos + 1;
    } 
  }
 }

 //use consistent parsing to extract elements
 if( pos < 8 )
 {
  temp = atof( sensorArray[0].c_str() );
  tempOutF = atof( sensorArray[1].c_str() );
  photoCellReading = atof( sensorArray[2].c_str() );
  humidity = atof( sensorArray[3].c_str() ); 
  soilMoisture = atoi( sensorArray[4].c_str() );
  soilMoisture2 = atoi( sensorArray[5].c_str() );
  soilMoisture3 = atoi( sensorArray[6].c_str() );
  soilCorrected = -.51*soilMoisture + 235; 
  soilCorrected2 = -.51*soilMoisture2 + 235;
  soilCorrected3 = -.51*soilMoisture3 + 235;
 }
 //soil moisture must be adjusted as it is a direct analog reading
 if( soilCorrected > 100 )
 {
   soilCorrected = 100;
 }
 else if( soilCorrected < 0 )
 {
  soilCorrected = 0;
 }
 if( soilCorrected2 > 100 )
 {
  soilCorrected2 = 100;
 }
 else if( soilCorrected2 < 0 )
 {
  soilCorrected2 = 0;
 }
  if( soilCorrected3 > 100 )
 {
  soilCorrected3 = 100;
 }
 else if( soilCorrected3 < 0 )
 {
  soilCorrected3 = 0;
 }
 
}


bool read_val = false;
unsigned long start_time = 0;
unsigned long end_time = 0;
void loop() {

    //read read_pin to see if arduino is sending data    
    digitalWrite( WIFI_ON, HIGH );

    //check that your connected and attempt to reconnect if not
    if( !client.connected() )
    {
      checkWiFiThenMQTT();
    }
    else
    {
       
      //if connected, stay connected
      client.loop();
      sendData();
      Serial.println( "connected" );/*
      time_t now = time(nullptr);
       struct tm* p_tm = localtime(&now);
       Hourminsec = p_tm->tm_sec;
       Hourminsec += p_tm->tm_min*100;
       Hourminsec += p_tm->tm_hour*10000;
       Yearmonthdate = p_tm->tm_mday;
       Yearmonthdate += (p_tm->tm_mon + 1)*100;
       Yearmonthdate += (p_tm->tm_year + 1900)*10000;*/
      delay( 100 );
      //LED indicates write is occurring
      digitalWrite( LED_PIN, HIGH );

      if (Serial.available() > 0) 
      {
      
        // read the oldest byte in the serial buffer:
        incomingString = Serial.readString();
        //check for prepending
        if( incomingString.length() > 3 )
        {
          if( incomingString[0] == 'D' && incomingString[1] == 'T' && incomingString[2] == 'A' )
          {
  
            //pjarse string and then send to AWS
            parseString( incomingString );
            sendData();
          }
        }
      delay( 5000 );
      }
      
  }
    
    
}
