hyshum/19-13-GreenHouse/Software/Arduino_and_NodeMCU_Embedded_System/test_relay/test_relay.ino

#include <dht.h>

dht DHT;
#define DHT11_PIN 4
#define LIGHT_PIN 0
#define OUTSIDE_TEMP_PIN 1

int in1 = 7;
void setup() {
  pinMode(in1, OUTPUT);
  digitalWrite(in1, LOW);
  Serial.begin(9600);
}
void loop() {
  int out_reading = analogRead( OUTSIDE_TEMP_PIN );
  float voltage = out_reading * 5;
  voltage /= 1024.0;

  float tempOutF = (voltage - 0.5) * 100 * 9.0/5.0 + 32;
  int chk = DHT.read11(DHT11_PIN);
  double temp = DHT.temperature * 1.8 + 32;
  double humidity = DHT.humidity;
  int on = 0;
  int photoCellReading = analogRead( LIGHT_PIN );
  Serial.print("light reading: " );
  Serial.println( photoCellReading );
  Serial.print("Temp = " );
  Serial.println( temp );
  Serial.print( "Temp outside = " );
  Serial.println( tempOutF );
  Serial.print("Humidity = ");
  Serial.println(DHT.humidity);
  
  if ( temp > 80 )
  {
    //if temperature is above 80, turn relay on and turn LED on
    digitalWrite( in1, LOW );
  }
  else if ( temp <= 80)
  {
    //if temperature is below LED, turn off relay and turn LED off
    digitalWrite(in1,HIGH);
  }


 delay(3000);
}
