hyshum/19-13-GreenHouse/(commit log)

2018-11-08 Adding README and arduino relay test code
2018-11-08 temp sensor arduino
    adding testing code for DHT11 temperature and humidity sensor
2018-11-08 added another temp sensor
    second temp sensor will eventually end up being the "outside" temperature sensor. as everything is still breadboarded, they are both inside temperature sensors for right now
2018-11-08 changed to respond to temp sensor
    previously responded to light sensor not temp sensor
2019-02-05 arduino/nodemcu split
    splitting code between arduino and nodemcu. also testing out serial communication between the boards
2019-02-12 Serial connection
    Added code for duplex serial connection. Still kind of a mess but proof of concept right now. LEDs indicate whether a string has been sent from one board to another. EXCITED!
2019-02-12 Serial Connection + Wifi
    Send data over serial connection between Arduino and NodeMCU. Can also then send to web app on phone. LEDs are used for debugging, will be removed
2019-02-28 AWS with Arduino and NodeMCU
    Added AWS functionality to Arduino and NodeMCU by switching serial connection on and off between boards and AWS server
2019-02-28 Adding soil moisture sensor
    Added soil moisture into arduino and parsing mechanism
2019-03-28 Create controlSwitch.py
    python script to send get request to turn switch on and off
2019-03-28 Update controlSwitch.py
    print response
2019-04-24 Add image via upload
    Photo of one of the sub-floor panels raised, exposing the heating pad and sub-floor supports beneath it.
2019-04-26 Created a markdown table for the BOM
2019-04-26 Uploaded flow chart
2019-04-27 Add files via upload
    Original JPEGs and a PDF containing both images of the heating pad.
